Antozjr/Super-5-RTOS/Archivos Placa/Medidas_modulos_BCM.xlsx

Super5 BCM — Medidas de módulos y conectores
Rellena SOLO las celdas amarillas (mide con calibre/regla, en mm). El resto déjalo. La fila "EJ" es un ejemplo del formato.
# | Categoría | Qué medir | Ref en KiCad | Típico (ref.) | Medida 1 (mm) | Medida 2 (mm) | Notas
EJ | Ejemplo | Separación entre filas | (ejemplo) | — | 22,86 | — | Así se rellena la casilla amarilla
1 | 🔴 Crítico | Separación entre las 2 filas de pines | Blue Pill (J3↔J4) | 17,8–22,9 |  |  | Ahora ~18,5 mm
2 | 🔴 Crítico | Separación entre las 2 filas de pines | ESP32 DevKit (J17↔J18) | 22–25 |  |  | Ahora ~13 mm → hay que ampliar
3 | 🟠 Buck | Paso IN+ ↔ IN- (dentro del par) | J_BKIN | 2,54
4 | 🟠 Buck | Paso OUT+ ↔ OUT- (dentro del par) | J_BKOUT | 2,54
5 | 🟠 Buck | Distancia par IN ↔ par OUT | J2 ↔ J20 | — |  |  | Largo del módulo
6 | 🟠 Fila | Paso de los 7 pines lógicos | MCP2515 (J_MCP) | 2,54
7 | 🟠 Fila | Paso de los 4 pines lógicos | TJA1050 (J_TJA) | 2,54
8 | 🟠 Fila | Orden de los pines (texto) | TJA1050 (J_TJA) | — |  |  | ← escribe aquí el orden, p.ej. VCC-TX-RX-GND
9 | 🟠 Bornera | Paso CANH ↔ CANL | MCP2515 bornera (J_MCPCAN) | 2,54 / 3,5 / 5
10 | 🟡 Cuerpo | Largo × Ancho | Blue Pill | ~53 × 22 |  |  | M1=largo · M2=ancho
11 | 🟡 Cuerpo | Largo × Ancho | ESP32 DevKit | ~52 × 28 |  |  | M1=largo · M2=ancho
12 | 🟡 Cuerpo | Largo × Ancho | MCP2515 | ~40 × 28 |  |  | M1=largo · M2=ancho
13 | 🟡 Cuerpo | Largo × Ancho | TJA1050 | ~20 × 20 |  |  | M1=largo · M2=ancho
14 | 🟡 Cuerpo | Largo × Ancho | Buck LM2596 | ~43 × 21 |  |  | M1=largo · M2=ancho
