Antozjr/Super-5-RTOS/(list of files, drawings)

Other design files:
Archivos Placa/DSN para freerouting.dsn
