Antozjr/Super-5-RTOS/Archivos Placa/Archivos Placa.kicad_pcb

## KiCad design Archivos Placa/Archivos Placa.kicad_pcb (2026-10-19)

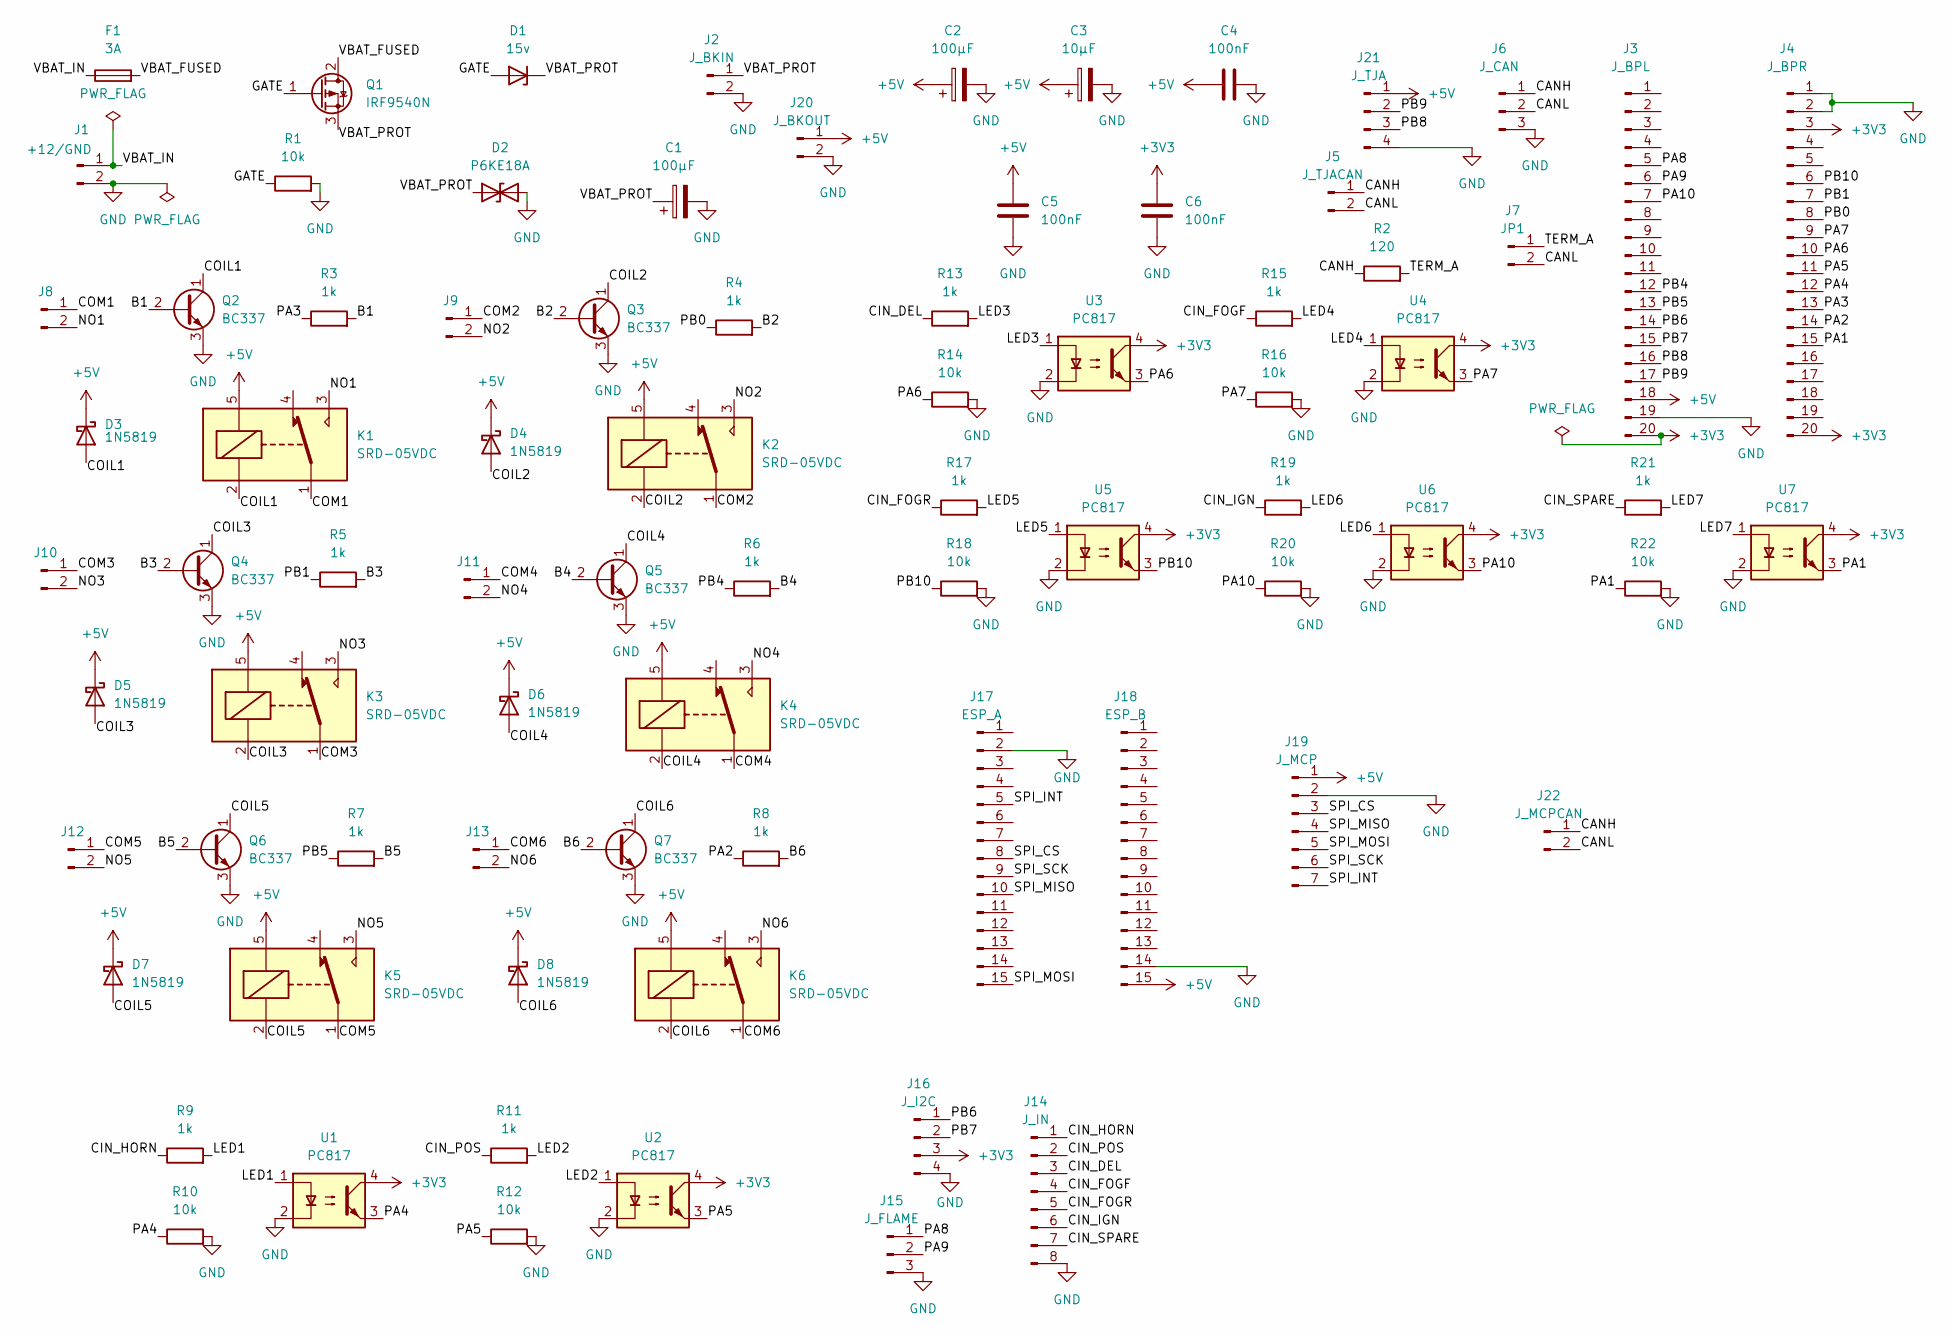
[picture p1: schematic Archivos Placa.kicad_sch]

Parts:
C1, C2: 100µF; CP_Radial_D6.3mm_P2.50mm
C3: 10µF; CP_Radial_D6.3mm_P2.50mm
C4, C5, C6: 100nF; C_Disc_D5.0mm_W2.5mm_P5.00mm
D1: 15v; D_DO-35_SOD27_P7.62mm_Horizontal
D2: P6KE18A; D_DO-15_P10.16mm_Horizontal
D3, D4, D5, D6, D7, D8: 1N5819; D_DO-41_SOD81_P10.16mm_Horizontal
F1: 3A; Fuseholder_Blade_Mini_Keystone_3568
J1: +12/GND; TerminalBlock_MaiXu_MX126-5.0-02P_1x02_P5.00mm
J2: J_BKIN; LM2596_pin_pair
J3: J_BPL; PinSocket_1x20_P2.54mm_Vertical
J4: J_BPR; PinSocket_1x20_P2.54mm_Vertical
J5: J_TJACAN; PinHeader_1x02_P2.54mm_Vertical
J6: J_CAN; JST_XH_B3B-XH-A_1x03_P2.50mm_Vertical
J7: JP1; PinHeader_1x02_P2.54mm_Vertical
J8, J9, J10, J11, J12, J13: TerminalBlock_MaiXu_MX126-5.0-02P_1x02_P5.00mm
J14: J_IN; JST_XH_B8B-XH-A_1x08_P2.50mm_Vertical
J15: J_FLAME; JST_XH_B3B-XH-A_1x03_P2.50mm_Vertical
J16: J_I2C; PinHeader_1x04_P2.54mm_Vertical
J17: ESP_A; PinSocket_1x15_P2.54mm_Vertical
J18: ESP_B; PinSocket_1x15_P2.54mm_Vertical
J19: J_MCP; PinSocket_1x07_P2.54mm_Vertical
J20: J_BKOUT; LM2596_pin_pair
J21: J_TJA; PinSocket_1x04_P2.54mm_Vertical
J22: J_MCPCAN; PinHeader_1x02_P2.54mm_Vertical
K1, K2, K3, K4, K5, K6: SRD-05VDC; Relay_SPDT_SANYOU_SRD_Series_Form_C
Q1: IRF9540N; TO-220-3_Vertical
Q2, Q3, Q4, Q5, Q6, Q7: BC337; TO-92_Inline
R1, R10, R12, R14, R16, R18, R20, R22: 10k; R_Axial_DIN0207_L6.3mm_D2.5mm_P10.16mm_Horizontal
R2: 120; R_Axial_DIN0207_L6.3mm_D2.5mm_P10.16mm_Horizontal
R3, R4, R5, R6, R7, R8, R9, R11, R13, R15, R17, R19, R21: 1k; R_Axial_DIN0207_L6.3mm_D2.5mm_P10.16mm_Horizontal
U1, U2, U3, U4, U5, U6, U7: PC817; DIP-4_W7.62mm

Connections:
+3V3: C6.1, J3.20, J4.3, J4.20, J16.3, U1.4, U2.4, U3.4, U4.4, U5.4, U6.4, U7.4
+5V: C2.1, C3.1, C4.2, C5.1, D3.1 (K), D4.1 (K), D5.1 (K), D6.1 (K), D7.1 (K), D8.1 (K), J3.18, J18.15, J19.1, J20.1, J21.1, K1.5, K2.5, K3.5, K4.5, K5.5, K6.5
/B1: Q2.2 (B), R3.2
/B2: Q3.2 (B), R4.2
/B3: Q4.2 (B), R5.2
/B4: Q5.2 (B), R6.2
/B5: Q6.2 (B), R7.2
/B6: Q7.2 (B), R8.2
/CANH: J5.1, J6.1, J22.1, R2.1
/CANL: J5.2, J6.2, J7.2, J22.2
/CIN_DEL: J14.3, R13.1
/CIN_FOGF: J14.4, R15.1
/CIN_FOGR: J14.5, R17.1
/CIN_HORN: J14.1, R9.1
/CIN_IGN: J14.6, R19.1
/CIN_POS: J14.2, R11.1
/CIN_SPARE: J14.7, R21.1
/COIL1: D3.2 (A), K1.2, Q2.1 (C)
/COIL2: D4.2 (A), K2.2, Q3.1 (C)
/COIL3: D5.2 (A), K3.2, Q4.1 (C)
/COIL4: D6.2 (A), K4.2, Q5.1 (C)
/COIL5: D7.2 (A), K5.2, Q6.1 (C)
/COIL6: D8.2 (A), K6.2, Q7.1 (C)
/COM1: J8.1, K1.1
/COM2: J9.1, K2.1
/COM3: J10.1, K3.1
/COM4: J11.1, K4.1
/COM5: J12.1, K5.1
/COM6: J13.1, K6.1
/GATE: D1.2 (A), Q1.1 (G), R1.1
/LED1: R9.2, U1.1
/LED2: R11.2, U2.1
/LED3: R13.2, U3.1
/LED4: R15.2, U4.1
/LED5: R17.2, U5.1
/LED6: R19.2, U6.1
/LED7: R21.2, U7.1
/NO1: J8.2, K1.3
/NO2: J9.2, K2.3
/NO3: J10.2, K3.3
/NO4: J11.2, K4.3
/NO5: J12.2, K5.3
/NO6: J13.2, K6.3
/PA1: J4.15, R22.1, U7.3
/PA2: J4.14, R8.1
/PA3: J4.13, R3.1
/PA4: J4.12, R10.1, U1.3
/PA5: J4.11, R12.1, U2.3
/PA6: J4.10, R14.1, U3.3
/PA7: J4.9, R16.1, U4.3
/PA8: J3.5, J15.1
/PA9: J3.6, J15.2
/PA10: J3.7, R20.1, U6.3
/PB0: J4.8, R4.1
/PB1: J4.7, R5.1
/PB4: J3.12, R6.1
/PB5: J3.13, R7.1
/PB6: J3.14, J16.1
/PB7: J3.15, J16.2
/PB8: J3.16, J21.3
/PB9: J3.17, J21.2
/PB10: J4.6, R18.1, U5.3
/SPI_CS: J17.8, J19.3
/SPI_INT: J17.5, J19.7
/SPI_MISO: J17.10, J19.4
/SPI_MOSI: J17.15, J19.5
/SPI_SCK: J17.9, J19.6
/TERM_A: J7.1, R2.2
/VBAT_FUSED: F1.2, Q1.2 (D)
/VBAT_IN: F1.1, J1.1
/VBAT_PROT: C1.1, D1.1 (K), D2.1 (A1), J2.1, Q1.3 (S)
GND: C1.2, C2.2, C3.2, C4.1, C5.2, C6.2, D2.2 (A2), J1.2, J2.2, J3.19, J4.1, J4.2, J6.3, J14.8, J15.3, J16.4, J17.2, J18.14, J19.2, J20.2, J21.4, Q2.3 (E), Q3.3 (E), Q4.3 (E), Q5.3 (E), Q6.3 (E), Q7.3 (E), R1.2, R10.2, R12.2, R14.2, R16.2, R18.2, R20.2, R22.2, U1.2, U2.2, U3.2, U4.2, U5.2, U6.2, U7.2

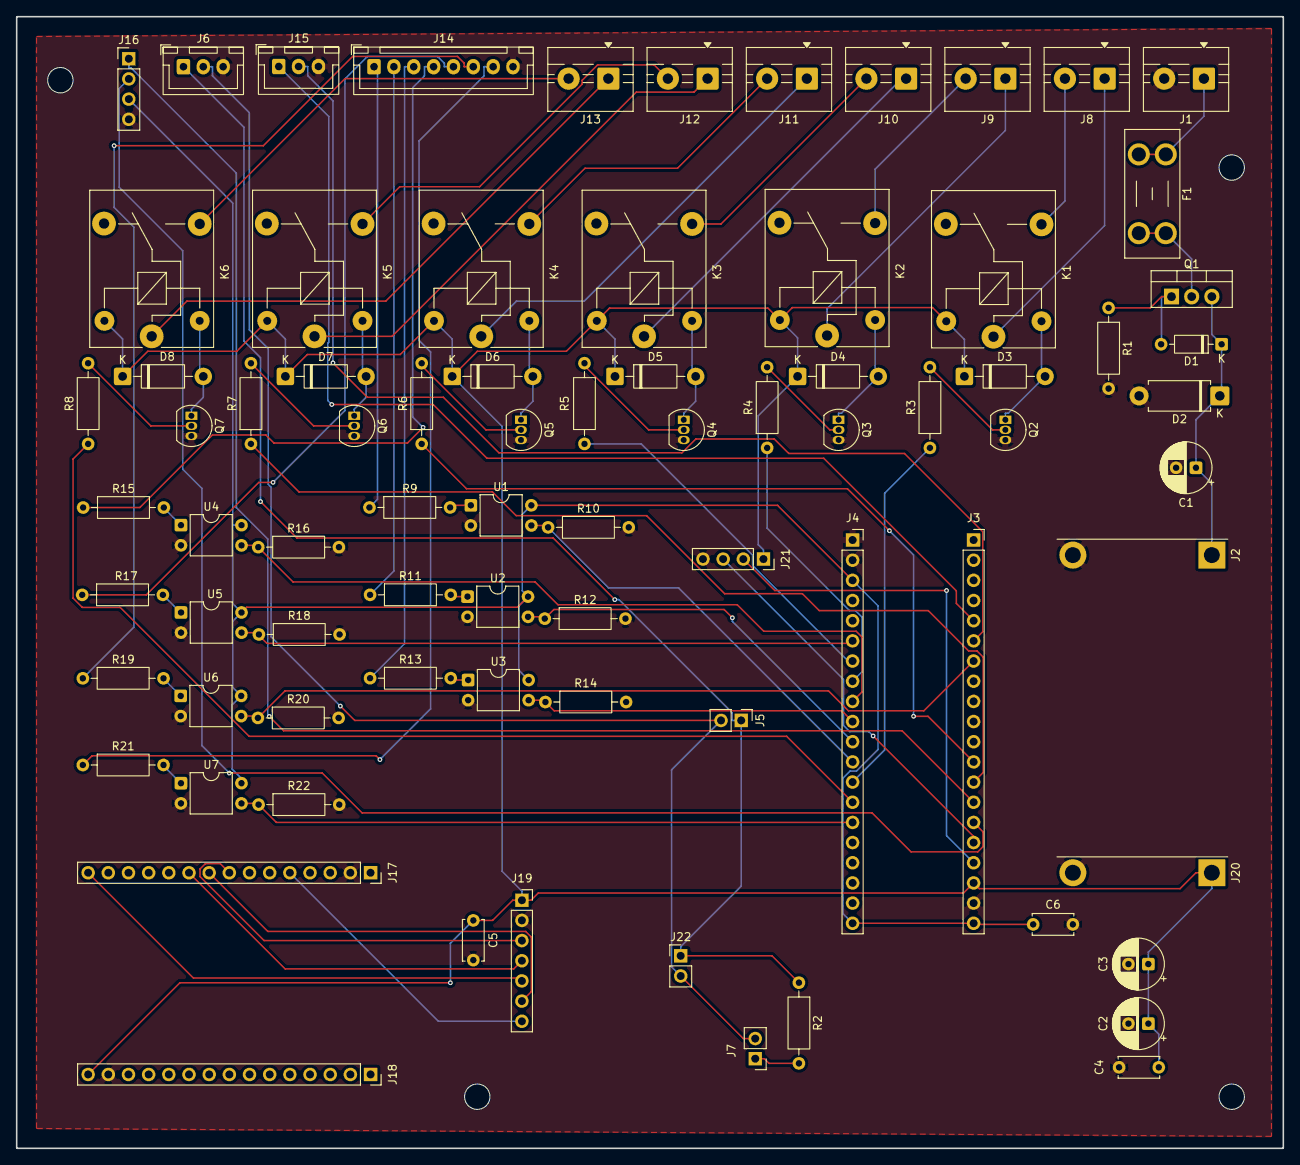
[picture p2: board Archivos Placa.kicad_pcb from above]

Board: 2 copper layers, 159.5 x 142.5 mm, 83 parts (0 on the bottom side), 72 nets.

Other parts of the board:
H1, H2, H3, H4: MountingHole_3.2mm_M3
