Antozjr/Super-5-RTOS/UCE/src/Tables.h

#ifndef TABLES_H
#define TABLES_H

#include <stdint.h>

/**
 * Tables.h - UCE: Tablas de calibración 3D
 *
 * Tablas interpolables 16×16 para:
 *   - VE (Volumetric Efficiency) → inyección
 *   - Ignition Advance           → encendido
 *   - AFR Target                 → mezcla objetivo
 *
 * Ejes:
 *   X = RPM  (16 puntos: 500, 1000, 1500... 8000)
 *   Y = MAP  (16 puntos: 20, 40, 60... 300 kPa)
 *
 * Valores almacenados como uint8_t (escala ×10 para VE/AFR,
 * int8_t para advance en grados).
 *
 * TODO: Ajustar valores base con dinamómetro.
 */

// =============================================================================
// EJES RPM Y MAP
// =============================================================================

#define TABLE_SIZE      16

static const uint16_t TABLE_RPM_AXIS[TABLE_SIZE] = {
    500, 1000, 1500, 2000, 2500, 3000, 3500, 4000,
    4500, 5000, 5500, 6000, 6500, 7000, 7500, 8000
};

static const uint16_t TABLE_MAP_AXIS[TABLE_SIZE] = {
    20,  40,  60,  80, 100, 120, 140, 160,
    180, 200, 220, 240, 260, 280, 300, 320
};

// =============================================================================
// TABLA VE (Volumetric Efficiency) - % × 10
// Rango: 0-100% (almacenado como 0-1000 en uint16_t)
// =============================================================================
// TODO: Valores iniciales conservadores, ajustar en banco.

static const uint8_t TABLE_VE[TABLE_SIZE][TABLE_SIZE] = {
    // MAP↑  RPM →  500  1000  1500  2000  2500  3000  3500  4000  4500  5000  5500  6000  6500  7000  7500  8000
    /* 20kPa */ { 30,  32,  34,  36,  37,  38,  37,  36,  35,  33,  31,  29,  27,  25,  23,  20 },
    /* 40kPa */ { 40,  44,  47,  50,  52,  53,  52,  51,  49,  47,  44,  42,  39,  36,  33,  28 },
    /* 60kPa */ { 50,  55,  59,  63,  65,  67,  66,  64,  62,  59,  56,  53,  49,  45,  41,  36 },
    /* 80kPa */ { 58,  63,  68,  72,  75,  77,  76,  74,  71,  68,  64,  60,  56,  51,  46,  40 },
    /*100kPa */ { 64,  70,  75,  80,  83,  85,  84,  82,  79,  75,  71,  67,  62,  57,  51,  44 },
    /*120kPa */ { 68,  74,  80,  85,  88,  90,  89,  87,  84,  80,  76,  71,  66,  60,  54,  47 },
    /*140kPa */ { 71,  77,  83,  88,  92,  94,  93,  91,  87,  83,  79,  74,  68,  62,  56,  49 },
    /*160kPa */ { 73,  79,  85,  90,  94,  96,  95,  93,  89,  85,  81,  76,  70,  64,  57,  50 },
    /*180kPa */ { 74,  80,  86,  91,  95,  97,  96,  94,  90,  86,  82,  77,  71,  65,  58,  51 },
    /*200kPa */ { 74,  80,  86,  91,  95,  97,  96,  94,  90,  86,  82,  77,  71,  65,  58,  51 },
    /*220kPa */ { 73,  79,  85,  90,  94,  96,  95,  93,  89,  85,  81,  76,  70,  64,  57,  50 },
    /*240kPa */ { 71,  77,  83,  88,  92,  94,  93,  91,  87,  83,  79,  74,  68,  62,  56,  49 },
    /*260kPa */ { 69,  75,  81,  86,  90,  92,  91,  89,  85,  81,  77,  72,  66,  60,  54,  47 },
    /*280kPa */ { 67,  73,  78,  83,  87,  89,  88,  86,  83,  79,  75,  70,  64,  58,  52,  45 },
    /*300kPa */ { 65,  70,  76,  80,  84,  86,  85,  83,  80,  76,  72,  67,  62,  56,  50,  43 },
    /*320kPa */ { 62,  68,  73,  77,  81,  83,  82,  80,  77,  73,  69,  64,  59,  53,  47,  41 },
};

// =============================================================================
// TABLA IGNITION ADVANCE - Grados BTDC (int8_t)
// =============================================================================

static const int8_t TABLE_IGN[TABLE_SIZE][TABLE_SIZE] = {
    // MAP↑  RPM →  500  1000  1500  2000  2500  3000  3500  4000  4500  5000  5500  6000  6500  7000  7500  8000
    /*  20kPa */ {  5,   8,  10,  12,  14,  16,  17,  18,  18,  18,  17,  16,  15,  14,  12,  10 },
    /*  40kPa */ {  5,   8,  11,  13,  16,  18,  20,  21,  21,  21,  20,  19,  17,  15,  13,  11 },
    /*  60kPa */ {  4,   7,  10,  13,  15,  18,  20,  22,  23,  23,  22,  21,  19,  17,  14,  12 },
    /*  80kPa */ {  3,   6,   9,  12,  15,  17,  20,  22,  24,  24,  23,  22,  20,  18,  15,  12 },
    /* 100kPa */ {  2,   5,   8,  11,  14,  16,  19,  21,  23,  24,  23,  22,  20,  18,  15,  12 },
    /* 120kPa */ {  1,   4,   7,  10,  13,  15,  18,  20,  22,  23,  22,  21,  19,  17,  14,  11 },
    /* 140kPa */ {  0,   3,   6,   9,  12,  14,  17,  19,  21,  22,  21,  20,  18,  16,  13,  10 },
    /* 160kPa */ { -1,   2,   5,   8,  11,  13,  16,  18,  20,  21,  20,  19,  17,  15,  12,   9 },
    /* 180kPa */ { -2,   1,   4,   7,  10,  12,  15,  17,  19,  20,  19,  18,  16,  14,  11,   8 },
    /* 200kPa */ { -2,   1,   4,   7,  10,  12,  14,  16,  18,  19,  18,  17,  15,  13,  10,   8 },
    /* 220kPa */ { -3,   0,   3,   6,   9,  11,  13,  15,  17,  18,  17,  16,  14,  12,   9,   7 },
    /* 240kPa */ { -3,   0,   3,   5,   8,  10,  12,  14,  16,  17,  16,  15,  13,  11,   8,   6 },
    /* 260kPa */ { -4,  -1,   2,   5,   7,   9,  11,  13,  15,  16,  15,  14,  12,  10,   7,   5 },
    /* 280kPa */ { -4,  -1,   2,   4,   7,   9,  11,  13,  15,  16,  15,  14,  12,  10,   7,   5 },
    /* 300kPa */ { -5,  -2,   1,   3,   6,   8,  10,  12,  14,  15,  14,  13,  11,   9,   6,   4 },
    /* 320kPa */ { -5,  -2,   1,   3,   5,   7,   9,  11,  13,  14,  13,  12,  10,   8,   5,   3 },
};

// =============================================================================
// TABLA AFR TARGET - × 10 (140 = AFR 14.0 = estequiométrico)
// =============================================================================

static const uint8_t TABLE_AFR[TABLE_SIZE][TABLE_SIZE] = {
    // MAP↑  RPM →  500  1000  1500  2000  2500  3000  3500  4000  4500  5000  5500  6000  6500  7000  7500  8000
    /* 20kPa */ { 147, 147, 147, 147, 147, 147, 147, 147, 147, 147, 147, 147, 147, 147, 147, 147 },
    /* 40kPa */ { 145, 145, 145, 145, 145, 145, 145, 145, 145, 145, 145, 145, 145, 145, 145, 145 },
    /* 60kPa */ { 143, 143, 143, 143, 143, 143, 143, 143, 143, 143, 143, 143, 143, 143, 143, 143 },
    /* 80kPa */ { 141, 141, 141, 141, 141, 141, 141, 141, 141, 141, 141, 141, 141, 141, 141, 141 },
    /*100kPa */ { 140, 140, 140, 140, 140, 140, 140, 140, 140, 140, 140, 140, 140, 140, 140, 140 },
    /*120kPa */ { 139, 139, 139, 139, 139, 139, 139, 139, 139, 139, 139, 139, 139, 139, 139, 139 },
    /*140kPa */ { 137, 137, 137, 137, 137, 137, 137, 137, 137, 137, 137, 137, 137, 137, 137, 137 },
    /*160kPa */ { 135, 135, 135, 135, 135, 135, 135, 135, 135, 135, 135, 135, 135, 135, 135, 135 },
    /*180kPa */ { 133, 133, 133, 133, 133, 133, 133, 133, 133, 133, 133, 133, 133, 133, 133, 133 },
    /*200kPa */ { 131, 131, 131, 131, 131, 131, 131, 131, 131, 131, 131, 131, 131, 131, 131, 131 },
    /*220kPa */ { 130, 130, 130, 130, 130, 130, 130, 130, 130, 130, 130, 130, 130, 130, 130, 130 },
    /*240kPa */ { 128, 128, 128, 128, 128, 128, 128, 128, 128, 128, 128, 128, 128, 128, 128, 128 },
    /*260kPa */ { 127, 127, 127, 127, 127, 127, 127, 127, 127, 127, 127, 127, 127, 127, 127, 127 },
    /*280kPa */ { 126, 126, 126, 126, 126, 126, 126, 126, 126, 126, 126, 126, 126, 126, 126, 126 },
    /*300kPa */ { 125, 125, 125, 125, 125, 125, 125, 125, 125, 125, 125, 125, 125, 125, 125, 125 },
    /*320kPa */ { 124, 124, 124, 124, 124, 124, 124, 124, 124, 124, 124, 124, 124, 124, 124, 124 },
};

// =============================================================================
// INTERPOLACIÓN BILINEAL (inline para rapidez)
// =============================================================================

#include <Arduino.h>

/**
 * Busca el índice inferior en un eje ordenado.
 */
static inline uint8_t tableAxisIndex(const uint16_t* axis, uint16_t value) {
    for (uint8_t i = 0; i < TABLE_SIZE - 1; i++) {
        if (value <= axis[i + 1]) return i;
    }
    return TABLE_SIZE - 2;
}

/**
 * Interpolación bilineal sobre tabla uint8_t.
 * @return Valor interpolado (misma escala que la tabla)
 */
static inline float tableLookup_u8(const uint8_t tbl[TABLE_SIZE][TABLE_SIZE],
                                   uint16_t rpm, uint16_t map_kpa10) {
    uint8_t xi = tableAxisIndex(TABLE_RPM_AXIS, rpm);
    uint8_t yi = tableAxisIndex(TABLE_MAP_AXIS, map_kpa10 / 10);

    float xf = (float)(rpm - TABLE_RPM_AXIS[xi]) /
               (TABLE_RPM_AXIS[xi+1] - TABLE_RPM_AXIS[xi]);
    float yf = (float)(map_kpa10/10 - TABLE_MAP_AXIS[yi]) /
               (TABLE_MAP_AXIS[yi+1] - TABLE_MAP_AXIS[yi]);

    float v00 = tbl[yi][xi];
    float v10 = tbl[yi][xi+1];
    float v01 = tbl[yi+1][xi];
    float v11 = tbl[yi+1][xi+1];

    return v00*(1-xf)*(1-yf) + v10*xf*(1-yf) + v01*(1-xf)*yf + v11*xf*yf;
}

/**
 * Interpolación bilineal sobre tabla int8_t (ignición).
 */
static inline float tableLookup_i8(const int8_t tbl[TABLE_SIZE][TABLE_SIZE],
                                   uint16_t rpm, uint16_t map_kpa10) {
    uint8_t xi = tableAxisIndex(TABLE_RPM_AXIS, rpm);
    uint8_t yi = tableAxisIndex(TABLE_MAP_AXIS, map_kpa10 / 10);

    float xf = (float)(rpm - TABLE_RPM_AXIS[xi]) /
               (TABLE_RPM_AXIS[xi+1] - TABLE_RPM_AXIS[xi]);
    float yf = (float)(map_kpa10/10 - TABLE_MAP_AXIS[yi]) /
               (TABLE_MAP_AXIS[yi+1] - TABLE_MAP_AXIS[yi]);

    float v00 = tbl[yi][xi];
    float v10 = tbl[yi][xi+1];
    float v01 = tbl[yi+1][xi];
    float v11 = tbl[yi+1][xi+1];

    return v00*(1-xf)*(1-yf) + v10*xf*(1-yf) + v01*(1-xf)*yf + v11*xf*yf;
}

#endif // TABLES_H
