Antozjr/Super-5-RTOS/(commit log)

2026-10-19 Super5 RTOS v3: firmware CAN multinodo y PCB BCM+Gateway (proyecto archivado)
    [Archivos Placa-B_Cu.gbr, Archivos Placa-B_Mask.gbr, Archivos Placa-B_Silkscreen.gbr, Archivos Placa-Edge_Cuts.gbr, Archivos Placa-F_Cu.gbr, Archivos Placa-F_Mask.gbr, Archivos Placa-F_Silkscreen.gbr, Archivos Placa-NPTH.drl]
2026-10-19 README: versión ampliada en español e inglés, estado de desarrollo detenido
